simple-ee/GRBL-Control-Board/20191222_Projects_Mainboard_A0.png

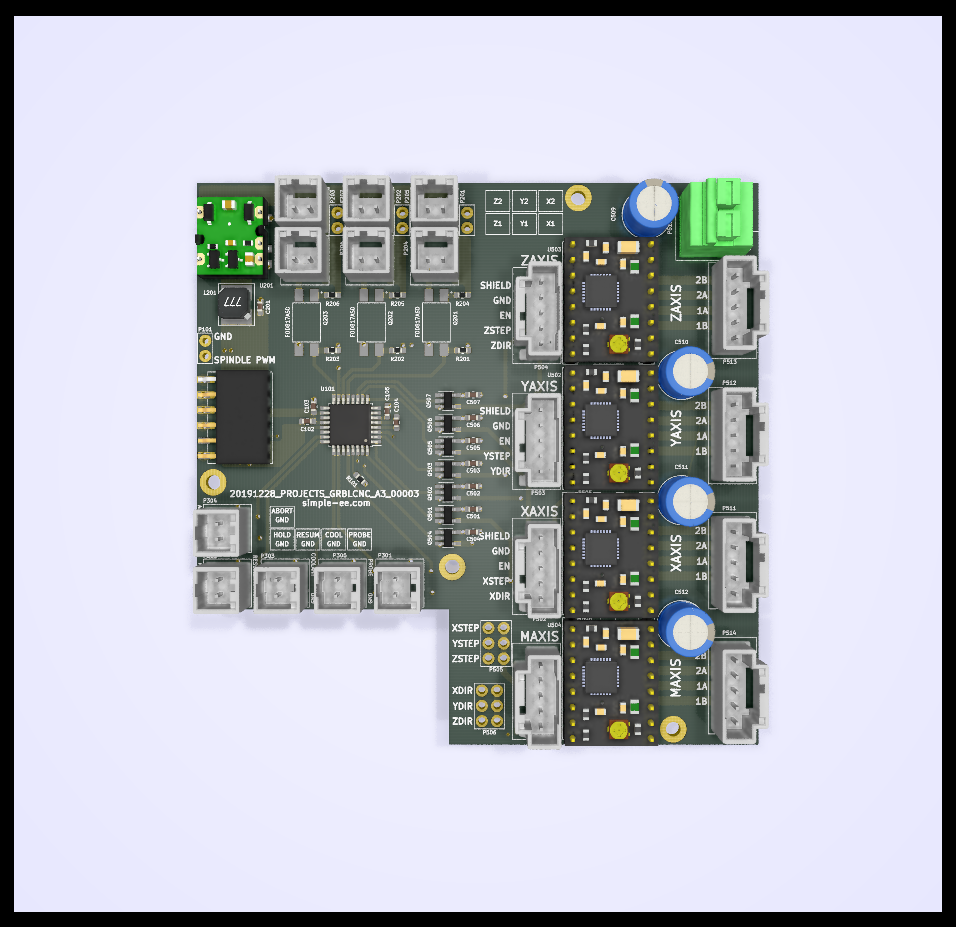
20191222_Projects_Mainboard_A0.png
