simple-ee/GRBL-Control-Board/README.md

# GRBL-Control-Board
Custom GRBL cnc machine control board with quality in mind
