simple-ee/GRBL-Control-Board/Diagrams/20200209_GRBLMainboard_2.pdf

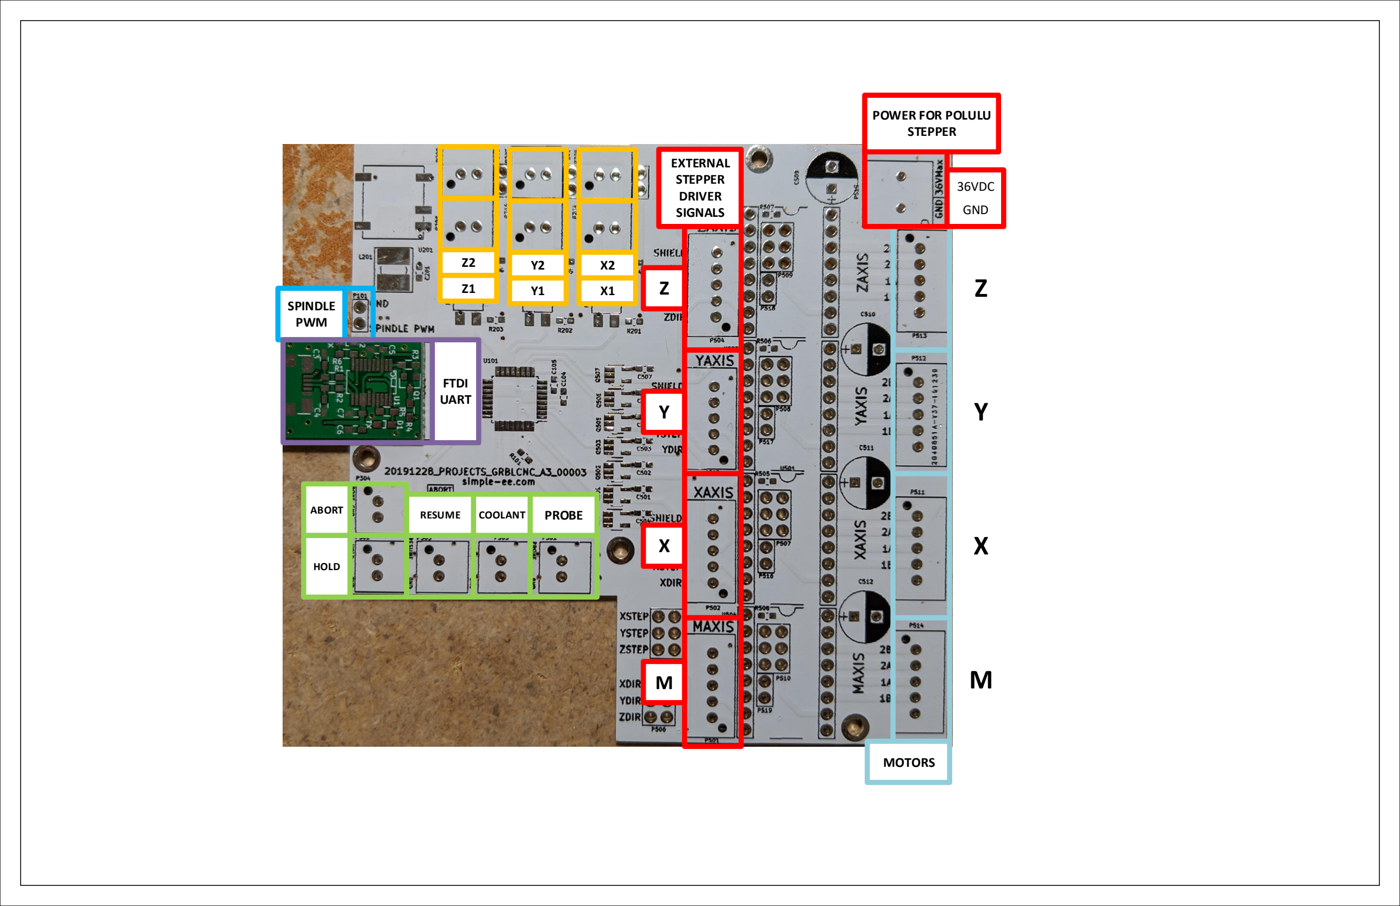
[picture p2: page 1]

X

Z

Y

M

MOTORS

EXTERNAL
STEPPER
DRIVER
SIGNALS

Z

Y

X

M

RESUME | COOLANT | PROBE

HOLD

ABORT

Z2

Z1

Y2

Y1

X2

X1
SPINDLE PWM
| FTDI UART

36VDC
GND

POWER FOR POLULU
STEPPER
