simple-ee/GRBL-Control-Board/Diagrams/20200209_GRBLMainboard.pdf

## FTDI PORT USED FOR PC TO BOARD

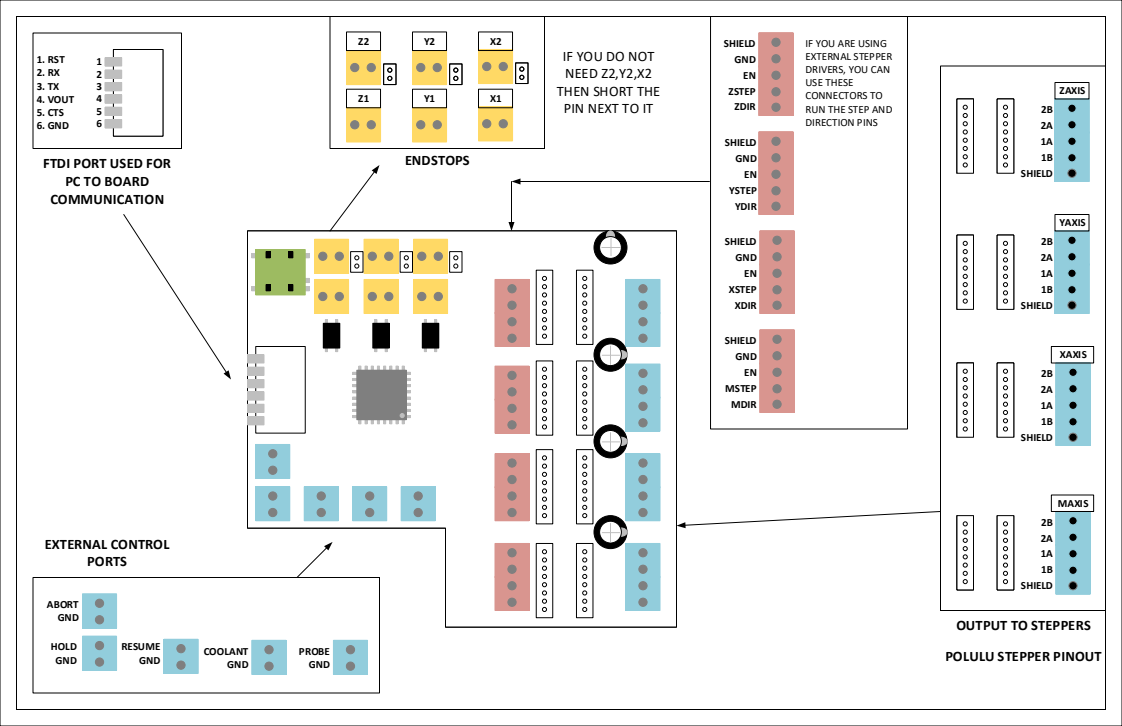
[picture p3: page 1]
1. RST 2. RX 3. TX 4. VOUT 5. CTS 6. GND; ABORT GND; HOLD GND; RESUME GND; COOLANT GND; PROBE GND; COMMUNICATION; EXTERNAL CONTROL PORTS; ENDSTOPS; SHIELD GND EN ZSTEP ZDIR; SHIELD GND EN YSTEP YDIR; SHIELD GND EN XSTEP XDIR; SHIELD GND EN MSTEP MDIR; 2B 2A 1A 1B SHIELD; ZAXIS; YAXIS; XAXIS; MAXIS

IF YOU ARE USING
EXTERNAL STEPPER
DRIVERS, YOU CAN
USE THESE
CONNECTORS TO
RUN THE STEP AND
DIRECTION PINS

IF YOU DO NOT
NEED Z2,Y2,X2
THEN SHORT THE
PIN NEXT TO IT

OUTPUT TO STEPPERS

POLULU STEPPER PINOUT
