simple-ee/GRBL-Control-Board/KicadFiles/20191222_Projects_Mainboard_A0.kicad_pcb

## KiCad design KicadFiles/20191222_Projects_Mainboard_A0.kicad_pcb (2020-02-10)

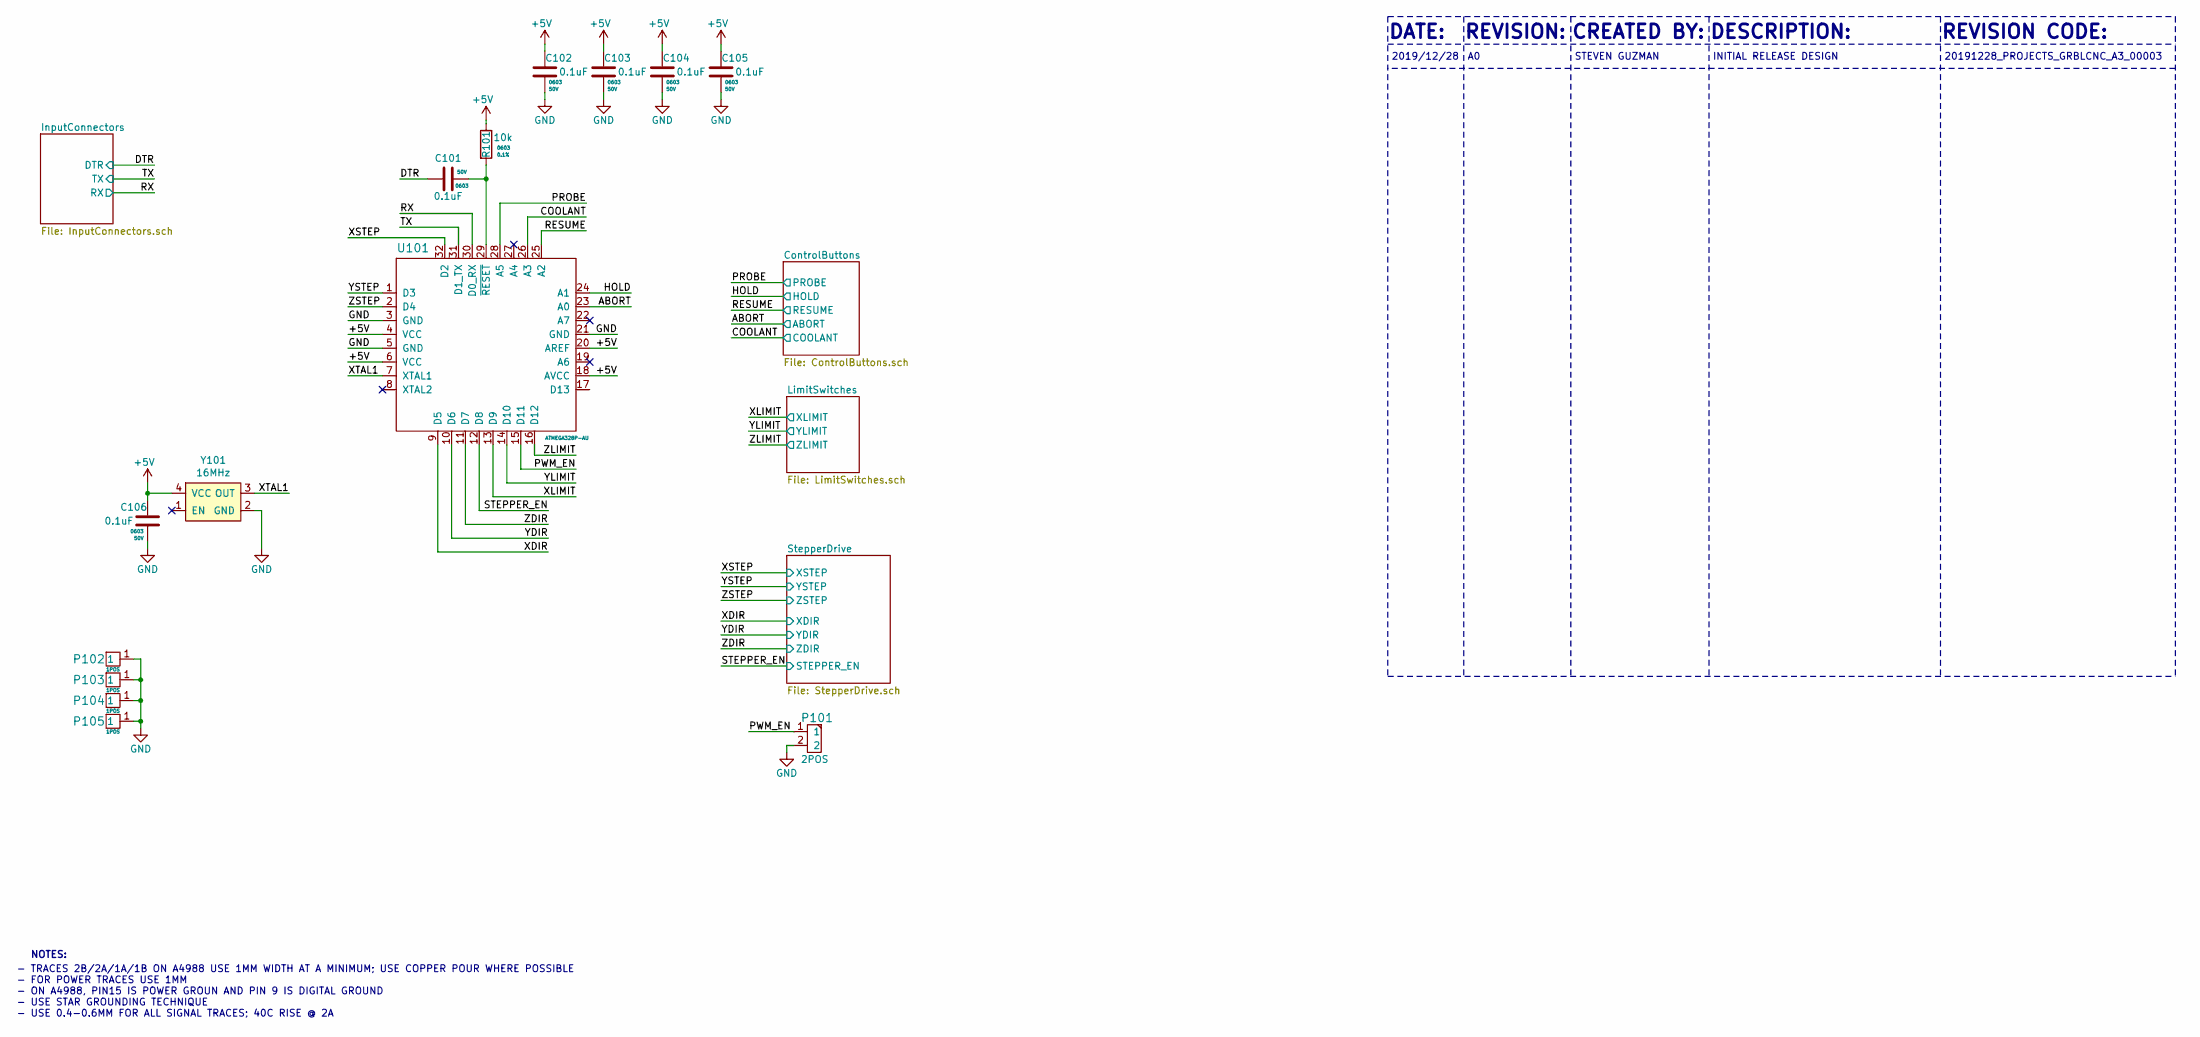
[picture p4: schematic 20191222_Projects_Mainboard_A0.sch]

Parts:
C101, C102, C103, C104, C105, C106: C0603C104K5RACAUTO; C_0603_Handsolder
P101: TH_2POS_2.54MM
P102, P103, P104, P105: TH_1POS_2.4MM_M2; TH_1POS_2.4MMxM2
R101: ERA-3AEB103V; R_0603_Handsolder
U101: ATMEGA328P-AU; TQFP-32
Y101: CB3-3I-16M0000; CB3

Connections:
+5V: C102.1, C103.1, C104.1, C105.1, C106.1, R101.1, U101.4 (VCC), U101.6 (VCC), U101.18 (AVCC), U101.20 (AREF), Y101.4 (VCC); also elsewhere on the board
/ABORT: U101.23 (A0); also elsewhere on the board
/COOLANT: U101.26 (A3); also elsewhere on the board
/DTR: C101.2; also elsewhere on the board
/HOLD: U101.24 (A1); also elsewhere on the board
/PROBE: U101.28 (A5); also elsewhere on the board
/PWM_EN: P101.1, U101.15 (D11)
/RESUME: U101.25 (A2); also elsewhere on the board
/RX: U101.30 (D0_RX); also elsewhere on the board
/STEPPER_EN: U101.12 (D8); also elsewhere on the board
/TX: U101.31 (D1_TX); also elsewhere on the board
/XDIR: U101.9 (D5); also elsewhere on the board
/XLIMIT: U101.13 (D9); also elsewhere on the board
/XSTEP: U101.32 (D2); also elsewhere on the board
/XTAL1: U101.7 (XTAL1), Y101.3 (OUT)
/YDIR: U101.10 (D6); also elsewhere on the board
/YLIMIT: U101.14 (D10); also elsewhere on the board
/YSTEP: U101.1 (D3); also elsewhere on the board
/ZDIR: U101.11 (D7); also elsewhere on the board
/ZLIMIT: U101.16 (D12); also elsewhere on the board
/ZSTEP: U101.2 (D4); also elsewhere on the board
GND: C102.2, C103.2, C104.2, C105.2, C106.2, P101.2, P102.1, P103.1, P104.1, P105.1, U101.3 (GND), U101.5 (GND), U101.21 (GND), Y101.2 (GND); also elsewhere on the board
unnamed: C101.1, R101.2, U101.29 (~RESET~)

Notes on the sheet:
DATE:
DESCRIPTION:
REVISION:
REVISION CODE:
2019/12/28
CREATED BY:
STEVEN GUZMAN
INITIAL RELEASE DESIGN
20191228_PROJECTS_GRBLCNC_A3_00003
- TRACES 2B/2A/1A/1B ON A4988 USE 1MM WIDTH AT A MINIMUM; USE COPPER POUR WHERE POSSIBLE - FOR POWER TRACES USE 1MM - ON A4988, PIN15 IS POWER GROUN AND PIN 9 IS DIGITAL GROUND - USE STAR GROUNDING TECHNIQUE - USE 0.4-0.6MM FOR ALL SIGNAL TRACES; 40C RISE @ 2A
NOTES:

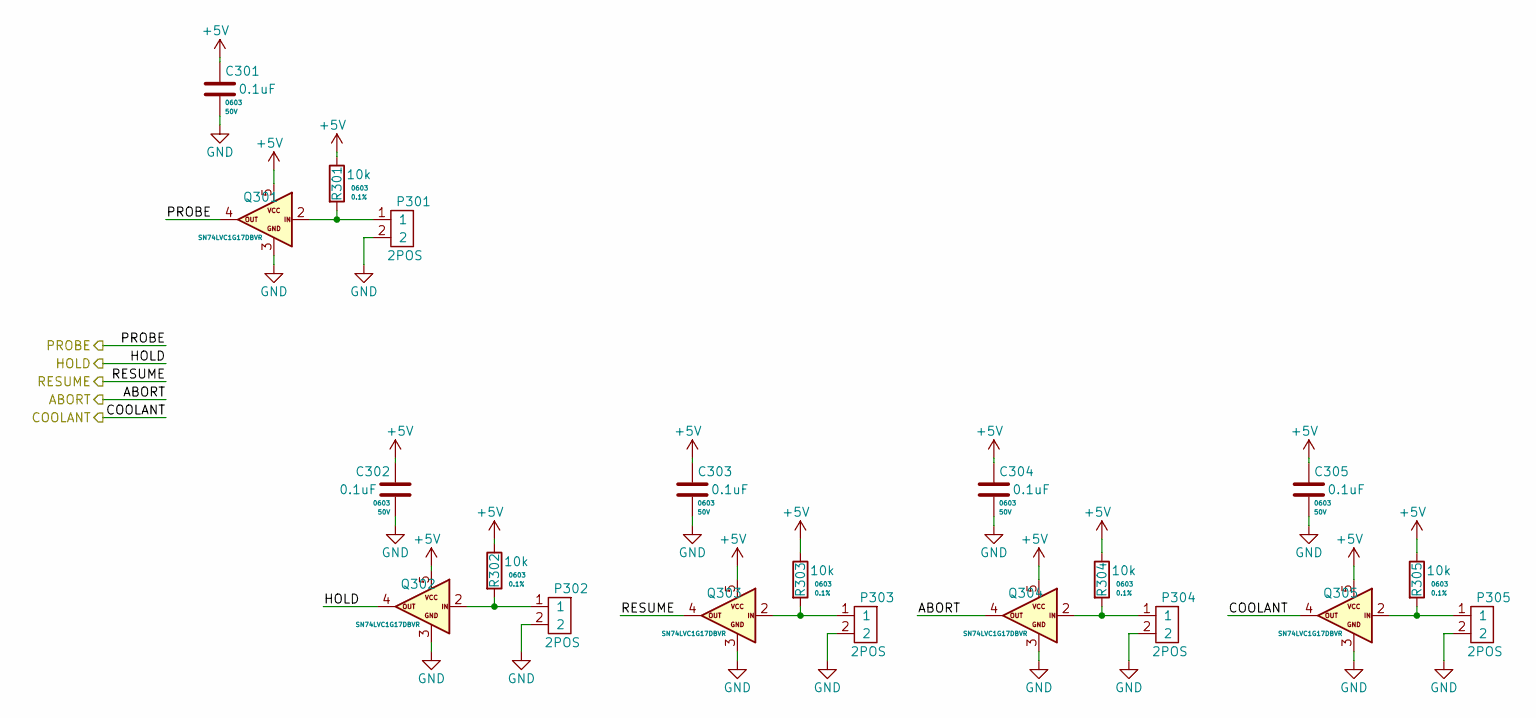
[picture p5: schematic ControlButtons.sch]

Parts:
C301, C302, C303, C304, C305: C0603C104K5RACAUTO; C_0603_Handsolder
P301, P302, P303, P304, P305: 2-1971798-4; 2-1971798
Q301, Q302, Q303, Q304, Q305: SN74LVC1G17DBVR; SOT-23-5_HandSoldering
R301, R302, R303, R304, R305: ERA-3AEB103V; R_0603_Handsolder

Connections:
+5V: C301.1, C302.1, C303.1, C304.1, C305.1, Q301.5, Q302.5, Q303.5, Q304.5, Q305.5, R301.1, R302.1, R303.1, R304.1, R305.1; also elsewhere on the board
/ABORT: Q304.4; also elsewhere on the board
/COOLANT: Q305.4; also elsewhere on the board
/HOLD: Q302.4; also elsewhere on the board
/PROBE: Q301.4; also elsewhere on the board
/RESUME: Q303.4; also elsewhere on the board
GND: C301.2, C302.2, C303.2, C304.2, C305.2, P301.2, P302.2, P303.2, P304.2, P305.2, Q301.3, Q302.3, Q303.3, Q304.3, Q305.3; also elsewhere on the board
unnamed: P301.1, Q301.2, R301.2
unnamed: P302.1, Q302.2, R302.2
unnamed: P303.1, Q303.2, R303.2
unnamed: P304.1, Q304.2, R304.2
unnamed: P305.1, Q305.2, R305.2

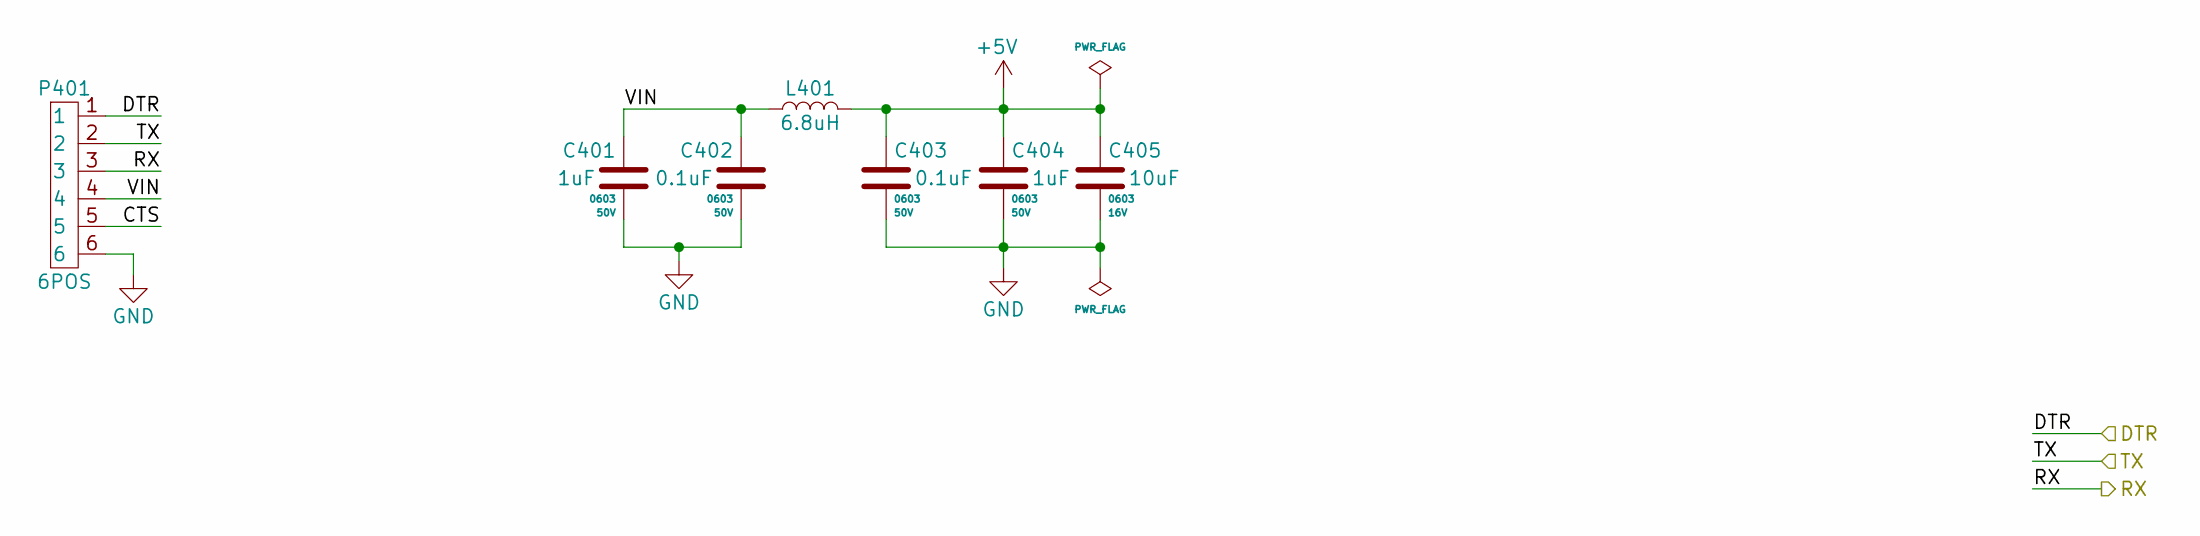
[picture p6: schematic InputConnectors.sch]

Parts:
C401, C404: CL10A105KB8NNNC; C_0603_Handsolder
C402, C403: C0603C104K5RACAUTO; C_0603_Handsolder
C405: CL10X106MO8NRNC; C_0603_Handsolder
L401: LPS6235-682MR_0; LPS6235
P401: M20-7910642R; M20

Connections:
+5V: C403.1, C404.1, C405.1, L401.2; also elsewhere on the board
/DTR: P401.1; also elsewhere on the board
/InputConnectors/VIN: C401.1, C402.1, L401.1, P401.4
/RX: P401.3; also elsewhere on the board
/TX: P401.2; also elsewhere on the board
GND: C401.2, C402.2, C403.2, C404.2, C405.2, P401.6; also elsewhere on the board

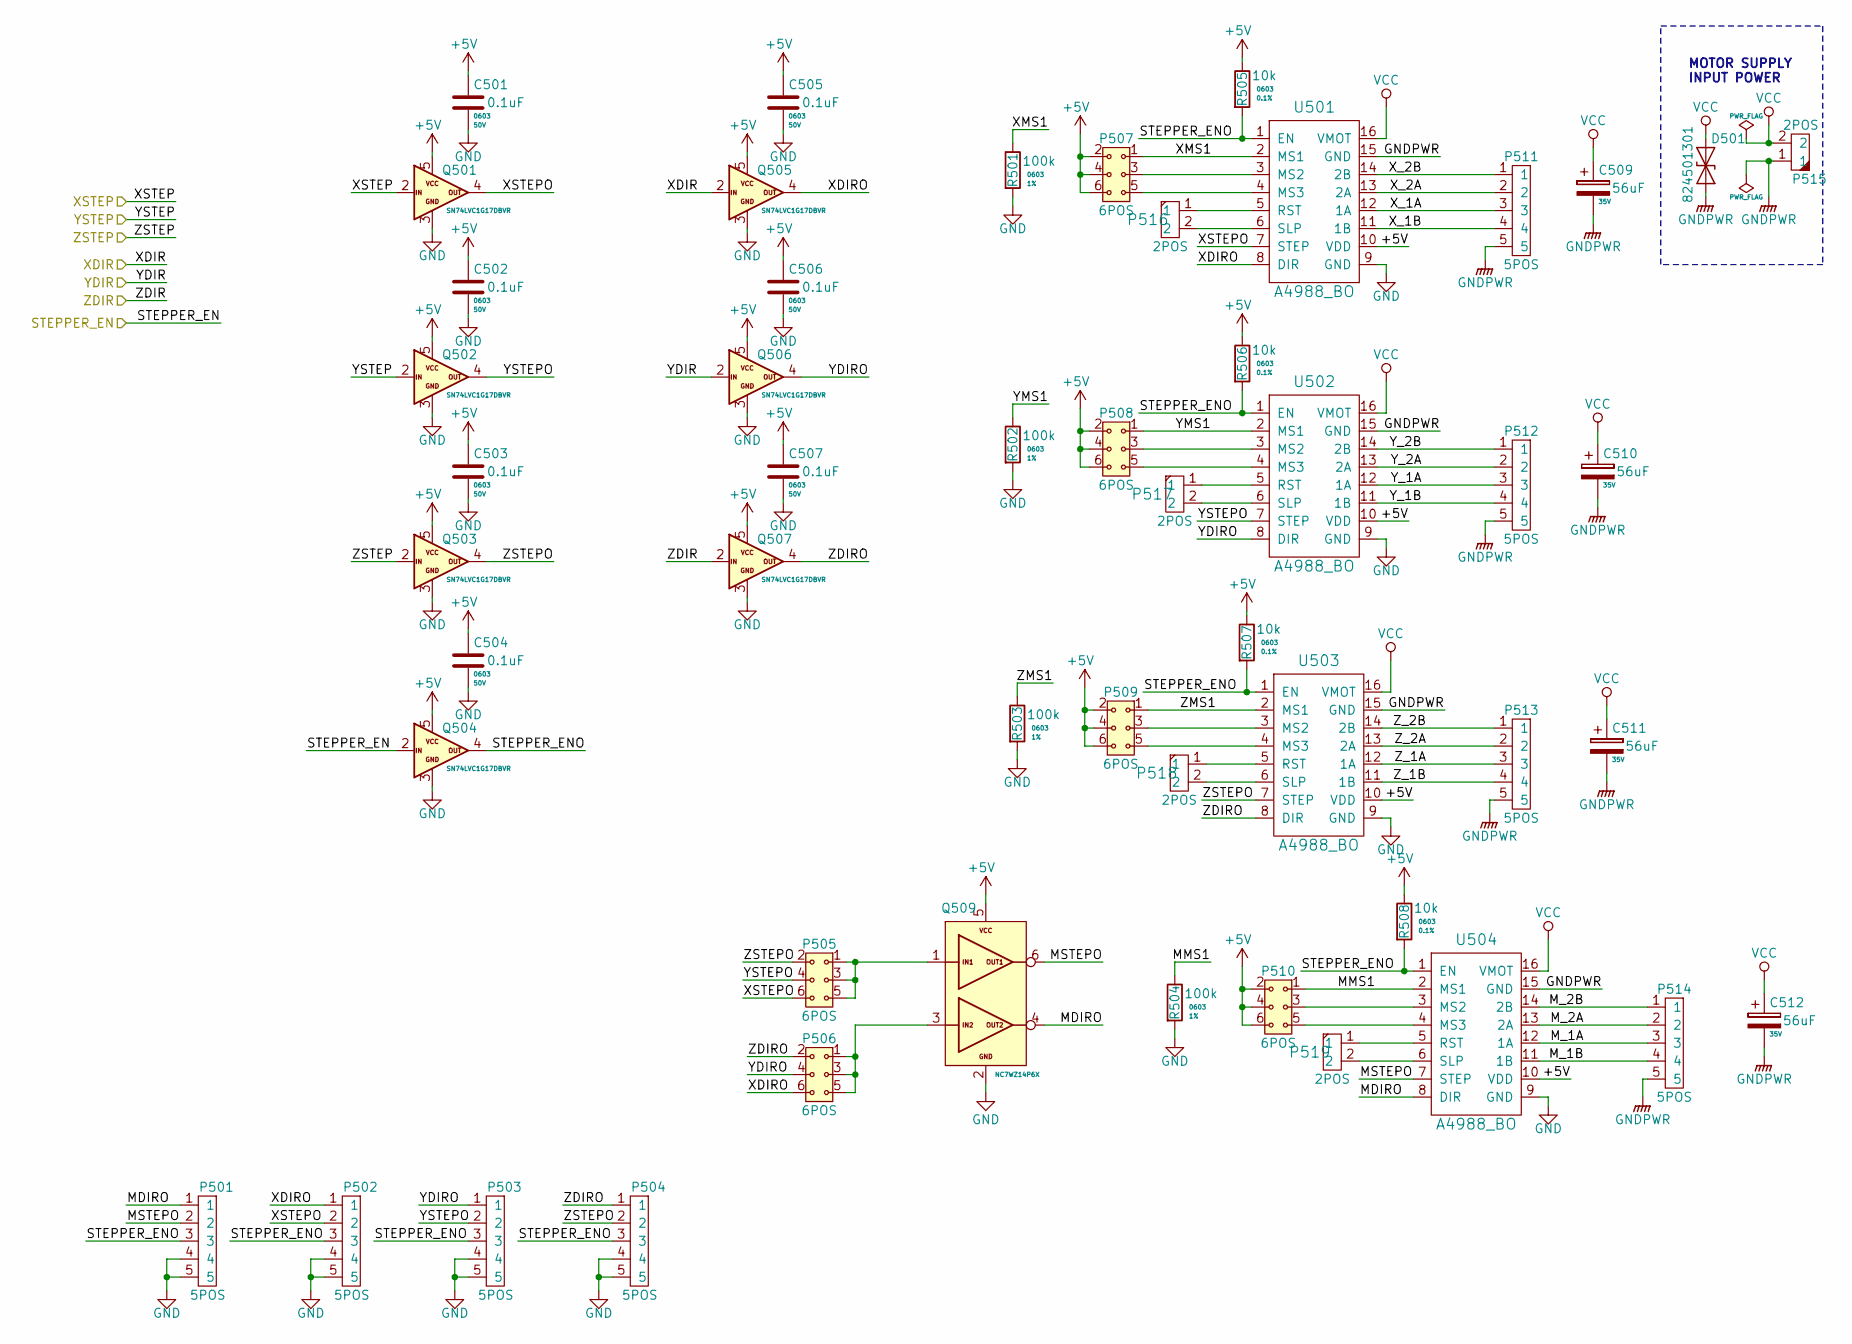
[picture p7: schematic StepperDrive.sch]

Parts:
C501, C502, C503, C504, C505, C506, C507: C0603C104K5RACAUTO; C_0603_Handsolder
C509, C510, C511, C512: 870055674006; Radial_D8.0mm_P3.50mm
D501: 824501301; D_SMA
P501, P502, P503, P504: 5-1971798-2
P505, P506, P507, P508, P509, P510: M20-9980346
P511, P512, P513, P514: 5-1971798-3; 5-1971798-2
P515: 1792863
P516, P517, P518, P519: TH_2POS_2.54MM
Q501, Q502, Q503, Q504, Q505, Q506, Q507: SN74LVC1G17DBVR; SOT-23-5_HandSoldering
Q509: NC7WZ14P6X; SOT-363_SC-70-6
R501, R502, R503, R504: CPF0603F100KC1; R_0603_Handsolder
R505, R506, R507, R508: ERA-3AEB103V; R_0603_Handsolder
U501, U502, U503, U504: A4988_BO; 2.54x12.7mm

Connections:
+5V: C501.1, C502.1, C503.1, C504.1, C505.1, C506.1, C507.1, P507.2, P507.4, P507.6, P508.2, P508.4, P508.6, P509.2, P509.4, P509.6, P510.2, P510.4, P510.6, Q501.5, Q502.5, Q503.5, Q504.5, Q505.5, Q506.5, Q507.5, Q509.5, R505.1, R506.1, R507.1, R508.1, U501.10 (VDD), U502.10 (VDD), U503.10 (VDD), U504.10 (VDD); also elsewhere on the board
/STEPPER_EN: Q504.2; also elsewhere on the board
/StepperDrive/MDIRO: P501.1, Q509.4, U504.8 (DIR)
/StepperDrive/MMS1: P510.1, R504.1, U504.2 (MS1)
/StepperDrive/MSTEPO: P501.2, Q509.6, U504.7 (STEP)
/StepperDrive/M_1A: P514.3, U504.12 (1A)
/StepperDrive/M_1B: P514.4, U504.11 (1B)
/StepperDrive/M_2A: P514.2, U504.13 (2A)
/StepperDrive/M_2B: P514.1, U504.14 (2B)
/StepperDrive/STEPPER_ENO: P501.3, P502.3, P503.3, P504.3, Q504.4, R505.2, R506.2, R507.2, R508.2, U501.1 (EN), U502.1 (EN), U503.1 (EN), U504.1 (EN)
/StepperDrive/XDIRO: P502.1, P506.6, Q505.4, U501.8 (DIR)
/StepperDrive/XMS1: P507.1, R501.1, U501.2 (MS1)
/StepperDrive/XSTEPO: P502.2, P505.6, Q501.4, U501.7 (STEP)
/StepperDrive/X_1A: P511.3, U501.12 (1A)
/StepperDrive/X_1B: P511.4, U501.11 (1B)
/StepperDrive/X_2A: P511.2, U501.13 (2A)
/StepperDrive/X_2B: P511.1, U501.14 (2B)
/StepperDrive/YDIRO: P503.1, P506.4, Q506.4, U502.8 (DIR)
/StepperDrive/YMS1: P508.1, R502.1, U502.2 (MS1)
/StepperDrive/YSTEPO: P503.2, P505.4, Q502.4, U502.7 (STEP)
/StepperDrive/Y_1A: P512.3, U502.12 (1A)
/StepperDrive/Y_1B: P512.4, U502.11 (1B)
/StepperDrive/Y_2A: P512.2, U502.13 (2A)
/StepperDrive/Y_2B: P512.1, U502.14 (2B)
/StepperDrive/ZDIRO: P504.1, P506.2, Q507.4, U503.8 (DIR)
/StepperDrive/ZMS1: P509.1, R503.1, U503.2 (MS1)
/StepperDrive/ZSTEPO: P504.2, P505.2, Q503.4, U503.7 (STEP)
/StepperDrive/Z_1A: P513.3, U503.12 (1A)
/StepperDrive/Z_1B: P513.4, U503.11 (1B)
/StepperDrive/Z_2A: P513.2, U503.13 (2A)
/StepperDrive/Z_2B: P513.1, U503.14 (2B)
/XDIR: Q505.2; also elsewhere on the board
/XSTEP: Q501.2; also elsewhere on the board
/YDIR: Q506.2; also elsewhere on the board
/YSTEP: Q502.2; also elsewhere on the board
/ZDIR: Q507.2; also elsewhere on the board
/ZSTEP: Q503.2; also elsewhere on the board
GND: C501.2, C502.2, C503.2, C504.2, C505.2, C506.2, C507.2, P501.4, P501.5, P502.4, P502.5, P503.4, P503.5, P504.4, P504.5, Q501.3, Q502.3, Q503.3, Q504.3, Q505.3, Q506.3, Q507.3, Q509.2, R501.2, R502.2, R503.2, R504.2, U501.9 (GND), U502.9 (GND), U503.9 (GND), U504.9 (GND); also elsewhere on the board
GNDPWR: C509.2, C510.2, C511.2, C512.2, D501.2 (A2), P511.5, P512.5, P513.5, P514.5, P515.1, U501.15 (GND), U502.15 (GND), U503.15 (GND), U504.15 (GND)
unnamed: P505.1, P505.3, P505.5, Q509.1
unnamed: P506.1, P506.3, P506.5, Q509.3
unnamed: P507.3, U501.3 (MS2)
unnamed: P507.5, U501.4 (MS3)
unnamed: P508.3, U502.3 (MS2)
unnamed: P508.5, U502.4 (MS3)
unnamed: P509.3, U503.3 (MS2)
unnamed: P509.5, U503.4 (MS3)
unnamed: P510.3, U504.3 (MS2)
unnamed: P510.5, U504.4 (MS3)
unnamed: P516.1, U501.5 (RST)
unnamed: P516.2, U501.6 (SLP)
unnamed: P517.1, U502.5 (RST)
unnamed: P517.2, U502.6 (SLP)
unnamed: P518.1, U503.5 (RST)
unnamed: P518.2, U503.6 (SLP)
unnamed: P519.1, U504.5 (RST)
unnamed: P519.2, U504.6 (SLP)
VCC: C509.1, C510.1, C511.1, C512.1, D501.1 (A1), P515.2, U501.16 (VMOT), U502.16 (VMOT), U503.16 (VMOT), U504.16 (VMOT)

Notes on the sheet:
MOTOR SUPPLY INPUT POWER

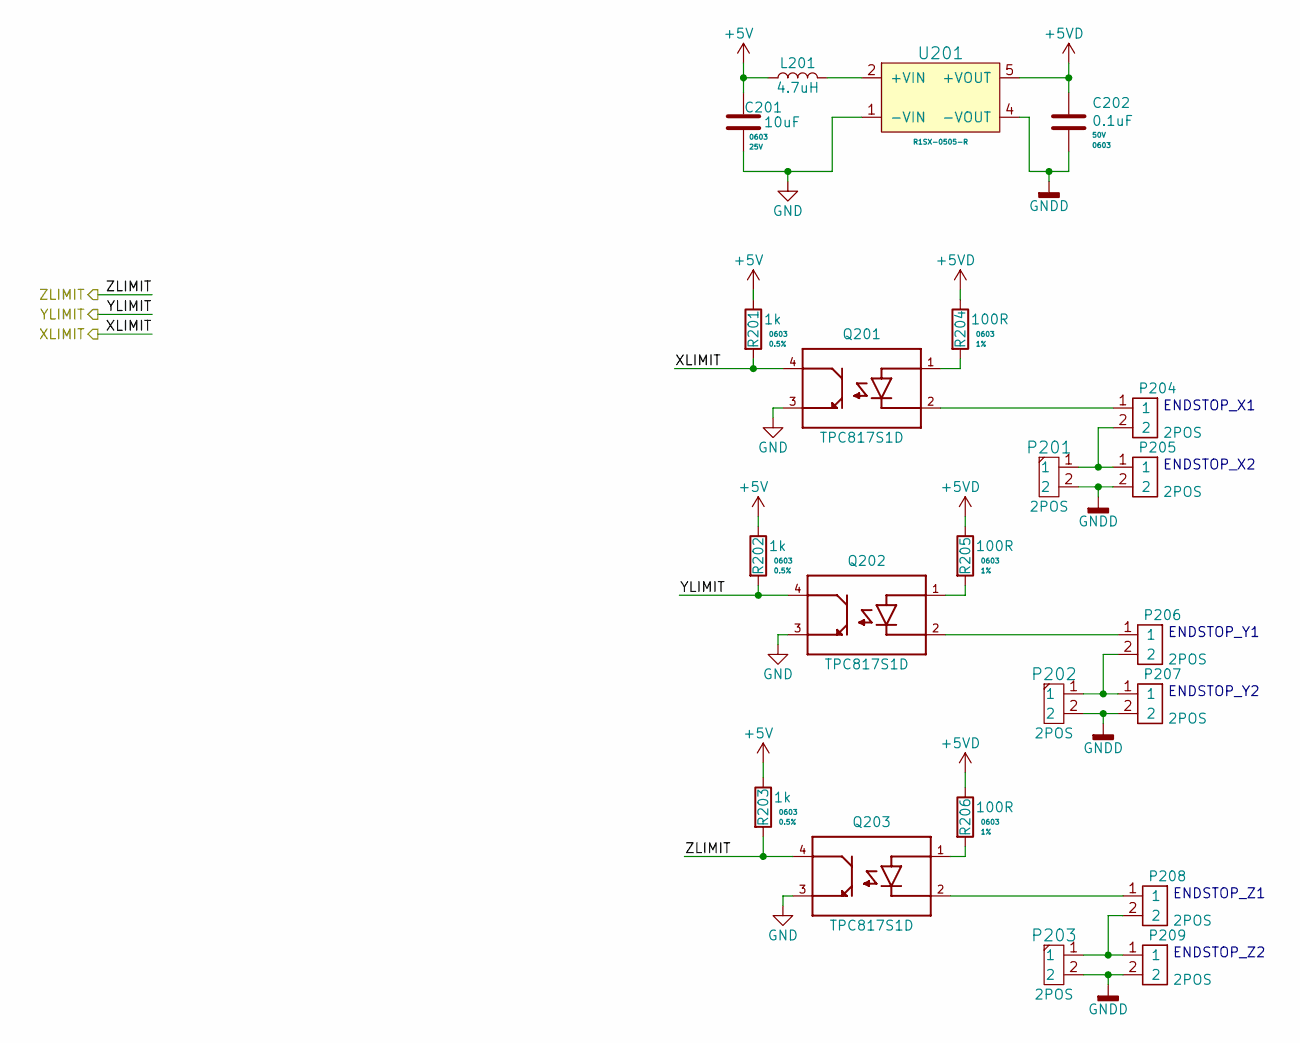
[picture p8: schematic LimitSwitches.sch]

Parts:
C201: ZRB18AR61E106ME01L; C_0603_Handsolder
C202: C0603C104K5RACAUTO; C_0603_Handsolder
L201: MSS5131-472ML; MSS5131
P201, P202, P203: TH_2POS_2.54MM
P204, P205, P206, P207, P208, P209: 2-1971798-2; 2-1971798
Q201, Q202, Q203: TPC817S1D; SMD-4
R201, R202, R203: RR0816P-102-D; R_0603_Handsolder
R204, R205, R206: RC0603FR-07100RL; R_0603_Handsolder
U201: R1SX-0505-R; Recom(8-smd)

Connections:
+5V: C201.1, L201.1, R201.1, R202.1, R203.1; also elsewhere on the board
+5VD: C202.1, R204.1, R205.1, R206.1, U201.5 (+VOUT)
/XLIMIT: Q201.4 (COLLECTOR), R201.2; also elsewhere on the board
/YLIMIT: Q202.4 (COLLECTOR), R202.2; also elsewhere on the board
/ZLIMIT: Q203.4 (COLLECTOR), R203.2; also elsewhere on the board
GND: C201.2, Q201.3 (EMITTER), Q202.3 (EMITTER), Q203.3 (EMITTER), U201.1 (-VIN); also elsewhere on the board
GNDD: C202.2, P201.2, P202.2, P203.2, P205.2, P207.2, P209.2, U201.4 (-VOUT)
unnamed: L201.2, U201.2 (+VIN)
unnamed: P201.1, P204.2, P205.1
unnamed: P202.1, P206.2, P207.1
unnamed: P203.1, P208.2, P209.1
unnamed: P204.1, Q201.2 (CATHODE)
unnamed: P206.1, Q202.2 (CATHODE)
unnamed: P208.1, Q203.2 (CATHODE)
unnamed: Q201.1 (ANODE), R204.2
unnamed: Q202.1 (ANODE), R205.2
unnamed: Q203.1 (ANODE), R206.2

Notes on the sheet:
ENDSTOP_X1
ENDSTOP_X2
ENDSTOP_Y1
ENDSTOP_Y2
ENDSTOP_Z1
ENDSTOP_Z2

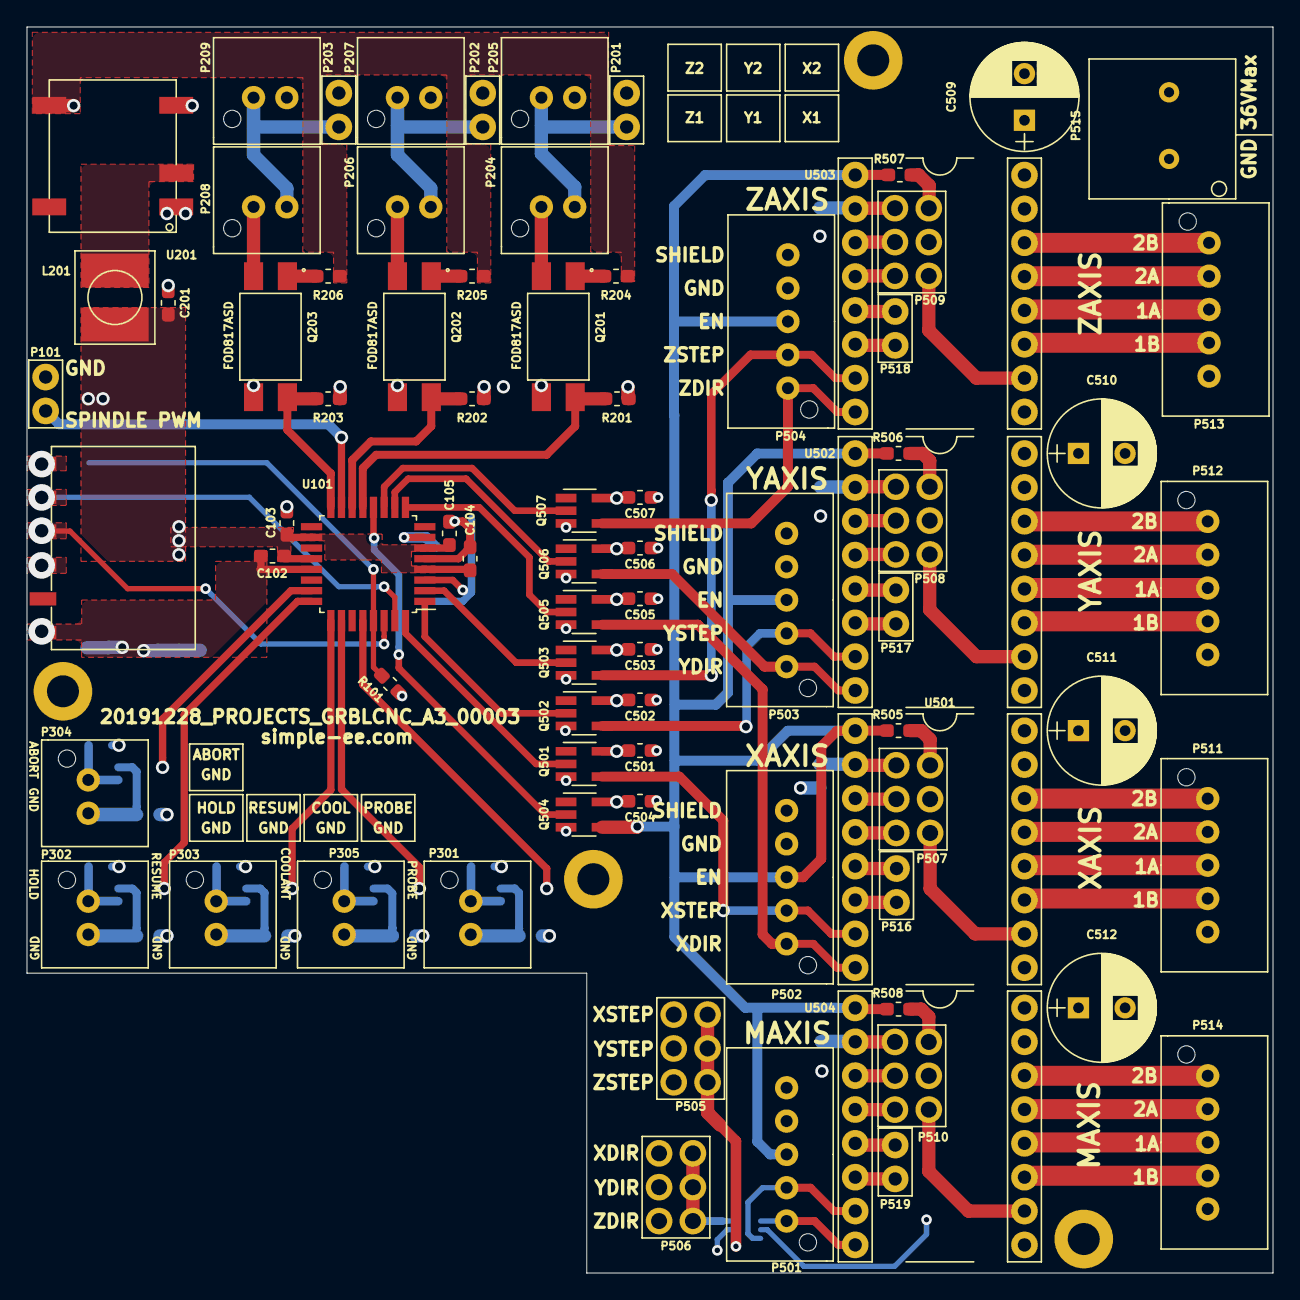
[picture p9: board 20191222_Projects_Mainboard_A0.kicad_pcb from above]

Board: 4 copper layers, 93.5 x 93.5 mm, 114 parts (0 on the bottom side), 90 nets.
